captainsmiley/train_switch/HW/esp12Board/DCDC.PNG

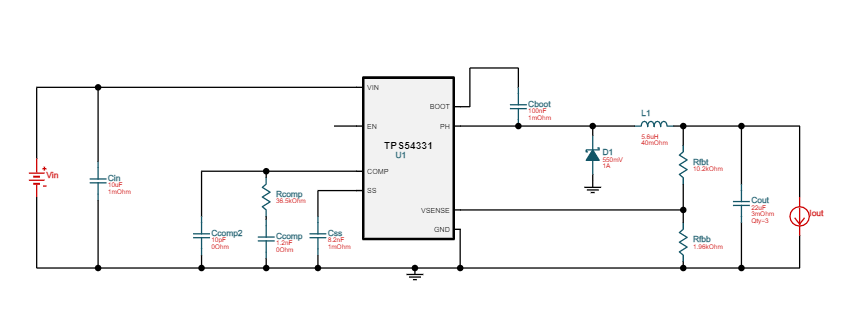
HW/esp12Board/DCDC.PNG
