captainsmiley/train_switch/HW/esp12Board/esp12Board.kicad_pcb

## KiCad design HW/esp12Board/esp12Board.kicad_pcb (2024-08-02)

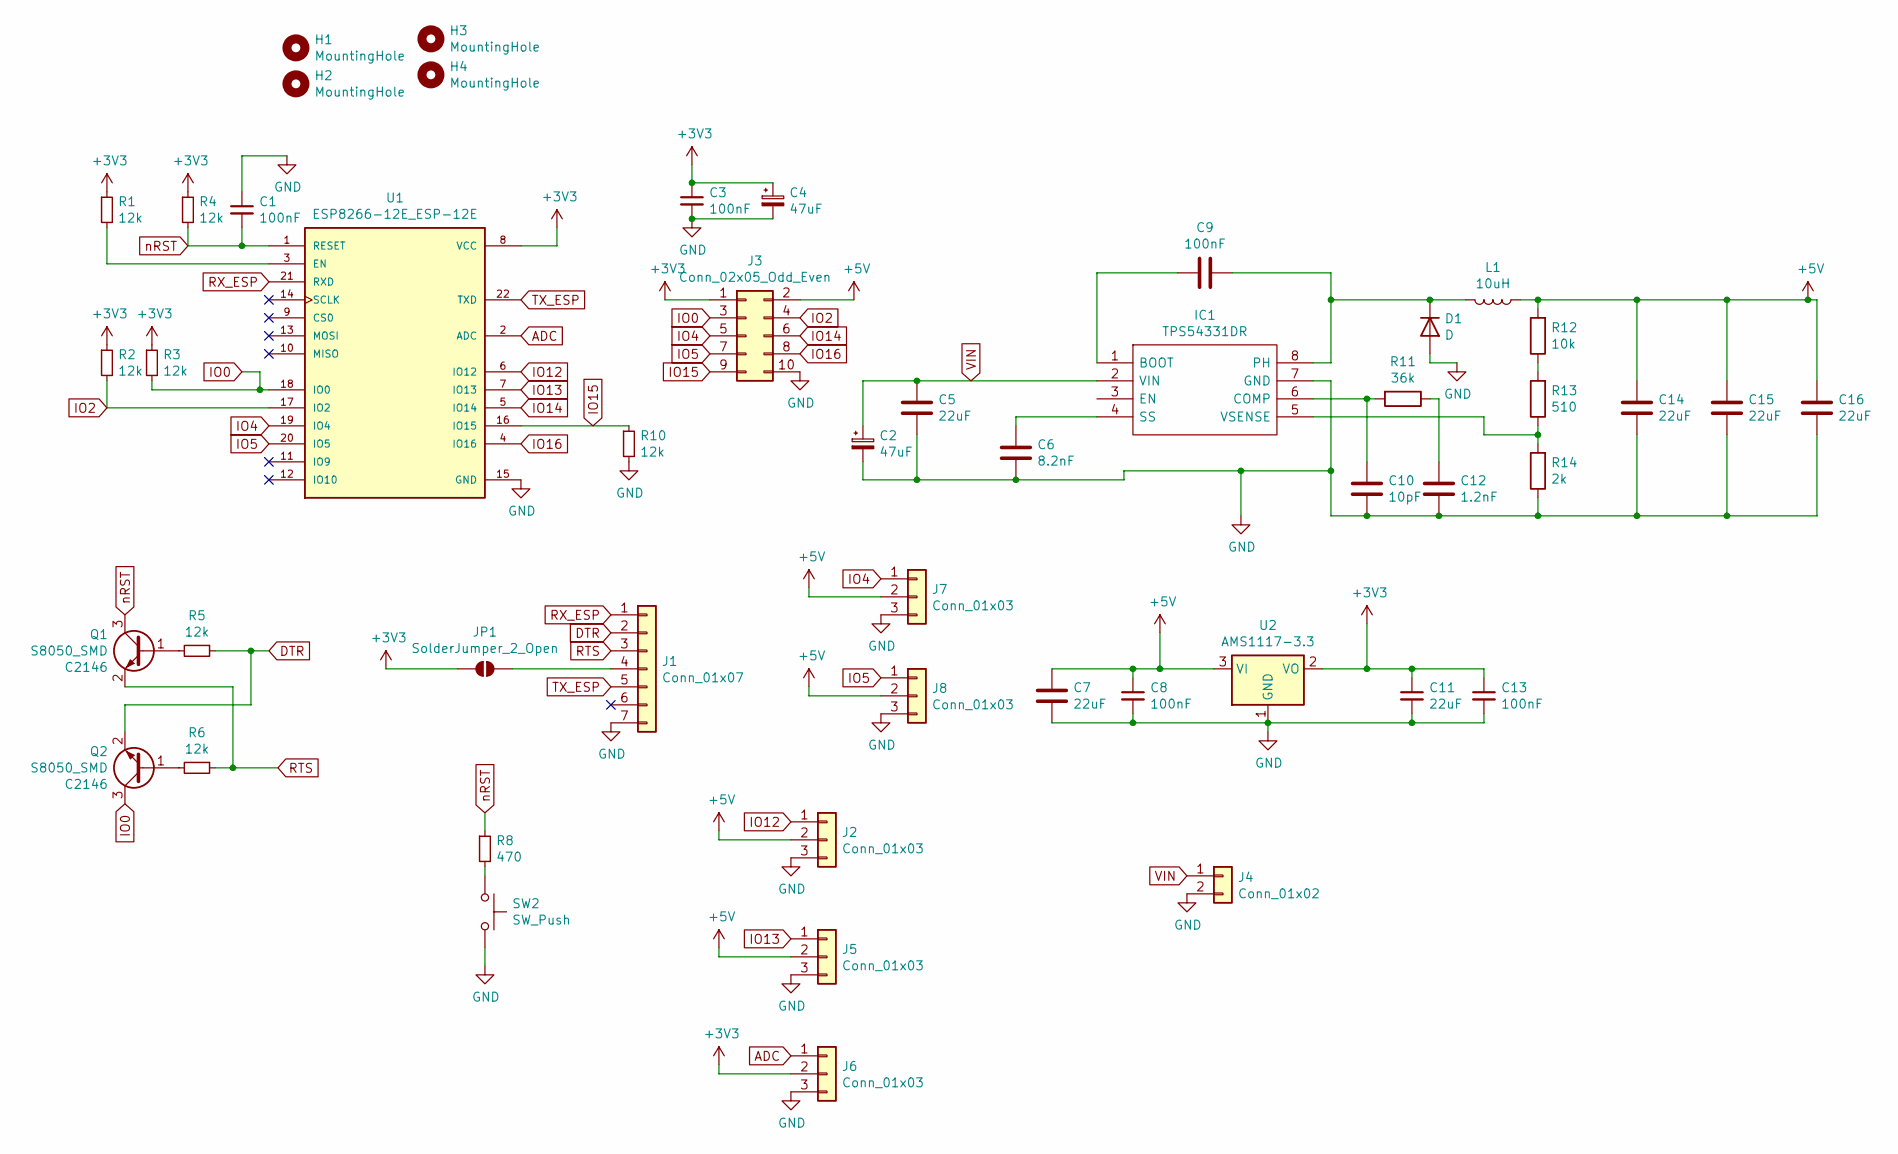
[picture p2: schematic esp12Board.kicad_sch]

Parts:
C1, C3, C8, C9, C13: 100nF; C_0805_2012Metric_Pad1.15x1.40mm_HandSolder; LCSC C49678
C2, C4: 47uF; CP_Elec_5x5.7; LCSC C7471868
C5, C7, C11, C14, C15, C16: 22uF; C_0805_2012Metric_Pad1.15x1.40mm_HandSolder; LCSC C45783
C6: 8.2nF; C_0603_1608Metric_Pad1.05x0.95mm_HandSolder; LCSC C1322360
C10: 10pF; C_0603_1608Metric_Pad1.08x0.95mm_HandSolder; LCSC C1634
C12: 1.2nF; C_0603_1608Metric_Pad1.05x0.95mm_HandSolder; LCSC C30615
D1: D; D_SOD-123; LCSC C8598
H1, H2, H3, H4: MountingHole; MountingHole_3.2mm_M3
IC1: TPS54331DR; SOIC127P600X175-8N; Mouser Part Number 595-TPS54331DR
J1: Conn_01x07; PinHeader_1x07_P2.54mm_Vertical
J2, J5, J6, J7, J8: Conn_01x03; PinHeader_1x03_P2.54mm_Vertical; LCSC C6332196
J3: Conn_02x05_Odd_Even; IDC-Header_2x05_P2.54mm_Vertical; LCSC C5372865
J4: Conn_01x02; TerminalBlock_Phoenix_MKDS-1,5-2-5.08_1x02_P5.08mm_Horizont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; LCSC C8465
JP1: SolderJumper_2_Open; SolderJumper-2_P1.3mm_Open_Pad1.0x1.5mm
L1: 10uH; L_Bourns_SRP7028A_7.3x6.6mm; LCSC C132141
Q1, Q2: S8050_SMD; SOT-23; LCSC C2146
R1, R2, R3, R4, R5, R6, R10: 12k; R_0805_2012Metric_Pad1.15x1.40mm_HandSolder; LCSC C17444
R8: 470; R_0805_2012Metric_Pad1.15x1.40mm_HandSolder; LCSC C17710
R11: 36k; R_0805_2012Metric_Pad1.15x1.40mm_HandSolder; LCSC C4360
R12: 10k; R_0805_2012Metric_Pad1.15x1.40mm_HandSolder; LCSC C17414
R13: 510; R_0805_2012Metric_Pad1.15x1.40mm_HandSolder; LCSC C17734
R14: 2k; R_0805_2012Metric_Pad1.15x1.40mm_HandSolder; LCSC C17604
SW2: SW_Push; SW_PUSH_6mm
U1: ESP8266-12E_ESP-12E; ESP-12E; LCSC C82891
U2: AMS1117-3.3; SOT-223-3_TabPin2; LCSC C6186

Connections:
+3V3: C3.1, C4.1, C11.1, C13.1, J3.1, J6.2, JP1.1 (A), R1.1, R2.1, R3.1, R4.1, U1.8 (VCC), U2.2 (VO)
+5V: C7.1, C8.1, C14.1, C15.1, C16.1, J2.2, J3.2, J5.2, J7.2, J8.2, L1.1, R12.2, U2.3 (VI)
ADC: J6.1, U1.2 (ADC)
DTR: J1.2, Q2.2 (E), R5.1
GND: C1.1, C2.2, C3.2, C4.2, C5.2, C6.2, C7.2, C8.2, C10.2, C11.2, C12.2, C13.2, C14.2, C15.2, C16.2, D1.2 (A), IC1.7 (GND), J1.7, J2.3, J3.10, J4.2, J5.3, J6.3, J7.3, J8.3, R10.2, R14.1, SW2.2, U1.15 (GND), U2.1 (GND)
IO0: J3.3, Q2.3 (C), R3.2, U1.18 (IO0)
IO2: J3.4, R2.2, U1.17 (IO2)
IO4: J3.5, J7.1, U1.19 (IO4)
IO5: J3.7, J8.1, U1.20 (IO5)
IO12: J2.1, U1.6 (IO12)
IO13: J5.1, U1.7 (IO13)
IO14: J3.6, U1.5 (IO14)
IO15: J3.9, R10.1, U1.16 (IO15)
IO16: J3.8, U1.4 (IO16)
unnamed: C12.1, R11.1
unnamed: C9.1, D1.1 (K), IC1.8 (PH), L1.2
unnamed: C9.2, IC1.1 (BOOT)
unnamed: C10.1, IC1.6 (COMP), R11.2
unnamed: C6.1, IC1.4 (SS)
unnamed: IC1.5 (VSENSE), R13.1, R14.2
unnamed: J1.4, JP1.2 (B)
unnamed: Q1.1 (B), R5.2
unnamed: Q2.1 (B), R6.2
unnamed: R8.2, SW2.1
unnamed: R12.1, R13.2
unnamed: R1.2, U1.3 (EN)
RTS: J1.3, Q1.2 (E), R6.1
RX_ESP: J1.1, U1.21 (RXD)
TX_ESP: J1.5, U1.22 (TXD)
VIN: C2.1, C5.1, IC1.2 (VIN), J4.1
nRST: C1.2, Q1.3 (C), R4.2, R8.1, U1.1 (RESET)

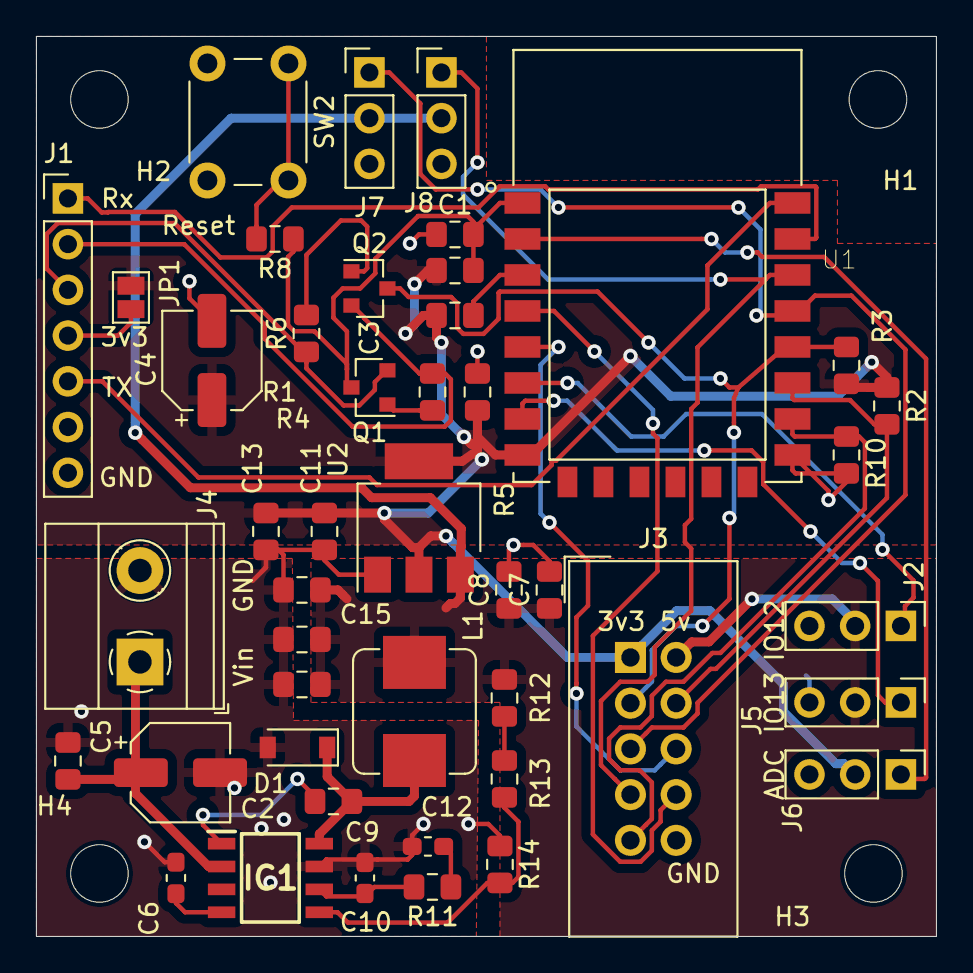
[picture p3: board esp12Board.kicad_pcb from above]

Board: 2 copper layers, 50.0 x 50.0 mm, 49 parts (0 on the bottom side), 31 nets.
