captainsmiley/train_switch/switch/src/commands.h

#ifndef SRC_COMMANDS_H_
#define SRC_COMMANDS_H_

#include <Arduino.h>
#include <ESP8266WiFi.h>
#include <EEPROM.h>
#include <WiFiUdp.h>

class tgesp;
//#include "Params.h"

#define SERVO_H_POS 100
#define SERVO_L_POS 10
#define SERVO_PIN 4
#define SERVO_DELAY 200

#include <Servo.h>

class Commands {
public:
    static Servo sv;
	Commands(tgesp *);
    static void test_gpio(const char * p);
    static void http_get();
    static void read_distance();
    static void read_client();
    static void test_servo(const char *p);
    void send_udp(const char *,size_t n,WiFiUDP & udp);
    void servo_h();
    void servo_l();
    void set_servo_h_pos(const char *p);
    void set_servo_l_pos(const char *p);
    void set_servo_delay(const char *p);
    void set_client_ip(const char *p);
    void send_params_serial(const char *p);
    void send_serial(const char *p);
    void wifi_setup(const char *p);
    void connect(const char *p);
    void set_id(const char *p);
    void controll(const char *p);
    uint8_t get_id();
	virtual ~Commands();

private:
	//Params pars_params(const char *p);

	IPAddress client_ip;
    uint8_t servo_h_pos;
    uint8_t servo_l_pos;
    tgesp *esp;

};

#endif /* SRC_TGESP_H_ */
