captainsmiley/train_switch/(commit log)

2021-05-19 Fixed npn orientation added contacts, remove boot sw
    [esp12Board.kicad_pcb, esp12Board.sch]
2021-05-19 Prep order v3
    [esp12Board-B_Cu.gbl, esp12Board-B_Mask.gbs, esp12Board-B_Paste.gbp, esp12Board-B_SilkS.gbo, esp12Board-Edge_Cuts.gm1, esp12Board-F_Cu.gtl, esp12Board-F_Mask.gts, esp12Board-F_Paste.gtp]
2024-08-02 update platta HW
    [bom.csv, designators.csv, esp12Board.kicad_pcb, esp12Board.kicad_sch, positions.csv]
